piersfinlayson/usb-ppps-hub/DEVELOPMENT.md

# USB PPPS Hub Development

The schematic, PCB and JLCPCB files are generated by the scripts in `scripts/`. It is recommended to change the scripts, not the files in KiCad, because regenerating overwrites KiCad edits. The design is in [spec.md](spec.md).

## Setup

Supported on macOS and Linux.

Install:

- [KiCad 9](https://www.kicad.org/download/)
- Python 3 and Git
- Poppler, for the PNG renders (`brew install poppler` on macOS, `poppler-utils` on Linux)
- CMake and the Arm GNU Toolchain (`arm-none-eabi-gcc`), for the EEPROM programmer
- [picotool](https://github.com/raspberrypi/picotool) 2.1.1 or later, for programming a hub
- [OpenSCAD](https://openscad.org/downloads.html#snapshots) development snapshot, for the case (`brew install --cask openscad@snapshot` on macOS)
- [PrusaSlicer](https://www.prusa3d.com/prusaslicer/), optional, for the case G-code

The scripts use KiCad's default install, and `kicad-cli` from the PATH if it's present. If your KiCad, OpenSCAD or PrusaSlicer is elsewhere, set these environment variables:

| Variable | Path |
| --- | --- |
| `KICAD_CLI` | `kicad-cli` |
| `KICAD_PYTHON` | Python with KiCad's `pcbnew` module |
| `KICAD9_SYMBOL_DIR` | KiCad's stock symbol libraries |
| `KICAD9_FOOTPRINT_DIR` | KiCad's stock footprint libraries |
| `OPENSCAD` | `openscad` |
| `PRUSASLICER` | PrusaSlicer |

`scripts/kicad-python` runs a script using KiCad's Python.

## Generating

```bash
scripts/generate.sh
```

This writes:

- the KiCad project and a schematic PDF to `kicad/`
- the JLCPCB files to `jlc/`
- the EEPROM image to `usb-ppps-hub-eeprom.bin`

It stops if there are uncommitted changes or untracked files. To see uncommitted changes in KiCad, run `scripts/check_pcb.sh build` and open `build/usb-ppps-hub.kicad_pro`.

Change ERC exclusions and other project settings in `kicad-src/usb-ppps-hub.kicad_pro`.

## Changing the Schematic

The schematic is generated by `scripts/usb_hub.py`. After changing the script, check the schematic:

```bash
scripts/check.sh build
```

This generates the schematic in `build/`, runs ERC and compares the netlist with `scripts/expected_nets.py`. It prints any netlist differences and ERC violations, and a `LAYOUT` line for overlapping symbols or text and for wires that cross them. The sheet is rendered to `build/sheet-1.png` at 100 dpi, or at `DPI` if set.

ERC violations excluded on a part reappear if the part moves or its reference changes.

`expected_nets.py` is the netlist written by hand from spec.md, separately from `usb_hub.py`. Update it when you change a connection, so a mistake in `usb_hub.py` appears as a netlist difference.

To see part of the sheet close up:

```bash
scripts/crop.sh build hub 50 5 100 60
```

This writes `build/hub.png` at 220 dpi, from x0 y0 to x1 y1 in units of 2.54 mm from the sheet's top left.

## Changing the PCB

The board is generated by `scripts/usb_hub_pcb.py`. Board size, connector pitch, and part and silkscreen positions are parameters at the top of the script. Tracks are built from pad positions, so a passive's footprint size can change without routing changes. The stackup is JLC04161H-7628 and the design rules are JLC's 4-layer limits.

Check the board:

```bash
scripts/check_pcb.sh build
```

This generates the schematic and board in `build/`, runs DRC with schematic parity and prints the violations, unconnected items and parity problems. It renders at 300 dpi or at `DPI` if set:

- the top layers to `build/top.png`
- the bottom copper to `build/bottom.png`
- the In2.Cu power plane to `build/power.png`

Generating the board also prints:

- `PAIR` lines with the length of each USB pair's tracks and the difference within the pair
- `STITCH` with the number of GND stitching vias placed
- `ANGLE` for a track segment that isn't horizontal, vertical or at 45°
- `ACUTE` for a track bend sharper than 90°
- `SILK` for a part with silkscreen outside the board outline
- `VIAPAD` for a via that overlaps a pad
- `UNPLACED` for any part without a position

Ignore DRC warnings that the USB-C connector footprints don't match the library.

To see part of a render close up:

```bash
scripts/crop_pcb.sh build top 30 10 45 30
```

This writes `build/top-crop.png` at 1200 dpi, or at `DPI` if set, from x0 y0 to x1 y1 in mm from the board's top left. The second argument is `top`, `bottom` or `power`.

When the board or case changes, update the renders in the README after running `generate.sh`:

```bash
scripts/render.sh
```

## Case

The case design is `case/usb-ppps-hub-case.scad`. Its specification is in [spec.md](spec.md#case).

```bash
scripts/case.sh build/usb-ppps-hub.kicad_pcb build/case
```

This:

- reads the board's size and its hole, connector and LED positions from the PCB into `build/case/board.scad`
- writes the base and lid STLs
- fails if the board, base and lid overlap
- writes G-code files for the for an Original Prusa MK3S with Prusament PLA, 0.20mm SPEED and 15% infill, if PrusaSlicer is installed.

`check_all.sh` runs it.

To see the case, open `build/case/usb-ppps-hub-case.scad` in OpenSCAD and set `part`. Edit `case/usb-ppps-hub-case.scad`, because `case.sh` overwrites the copy.

## Version, Commit and Source Location

The version in `VERSION` is the board version. It is printed in the schematic's title block and on the silkscreen, and written to the EEPROM as bcdDevice. Change it only when the board design is modified.

`generate.sh` sets the commit on the silkscreen to the short hash of HEAD.

https://piers.rocks on the left edge is `SOURCE_LOCATION` in `scripts/usb_hub_pcb.py`. The [LICENSE](LICENSE) and [NOTICE](NOTICE) require it remain on the PCB.

## EEPROM Image

The image is built from the EEPROM contents table in [spec.md](spec.md#hub-configuration):
- A value in double quotes is interpreted as a string.
- The string must be the correct length for the range.
- `VERSION` is the version in the `VERSION` file, used for bcdDevice.

## EEPROM Programmer

The EEPROM is programmed using a Raspberry Pi Pico or Pico 2 using:
- Pico firmware in `programmer/main.c`
- the `programmer/program.py` script to control it from a PC/Mac/Linux host

To build the firmware:

```bash
scripts/build_programmer.sh
```

This builds in `build/` and copies the firmware to:

- `programmer/rp2040.uf2` for a Pico
- `programmer/rp2350.uf2` for a Pico 2

`--clean` deletes the build folders first.

The Pico SDK at `PICO_SDK_PATH` is used. If that isn't set, pico-sdk 2.2.0 is cloned into `build/pico-sdk`.

If picotool 2.1.1 or later isn't installed, the SDK builds one in `build/picotool`. This requires a C++ compiler. That picotool doesn't have USB support so it cannot be used to program a hub.

Wire a Pico or Pico 2 to the hub as described in the [README](README.md#programming-the-eeprom). To program the hub with the EEPROM image from spec.md:

```bash
scripts/program_hub.sh
```

This:

- writes the EEPROM image to `build/`
- builds the firmware
- runs `program.py`

Options, passed to `program.py`:

- `--serial` sets the serial number. Otherwise it is a random 64-bit value from the OS's random number generator.
- `--board-version` sets bcdDevice. Otherwise it is the version from the `VERSION` file.

## JLCPCB Files

`generate.sh` runs `scripts/jlc.py`, which writes the zipped Gerbers and drill files, the BOM and the CPL to `jlc/`.

DNP parts and the mounting holes aren't in the BOM or CPL. `jlc.py` prints `NOLCSC` for any BOM row without an LCSC part number.

If a part is rotated or shifted in JLC's preview, add a correction for its LCSC part number to `CORRECTIONS` in `scripts/jlc.py`.

## Validation

```bash
scripts/check_all.sh build
```

This runs the schematic, board and case checks and builds the EEPROM image. CI runs it with KiCad 9.0.7 and the OpenSCAD 2026.10.11 snapshot and then `scripts/build_programmer.sh --clean`.

OpenSCAD deletes its snapshots after about a year. When CI fails to download the snapshot, change it in both workflows to a newer one.

## Releasing

A release is named after the board version in `VERSION`. The first release for a board version is named the version, for example v0.1.0. Later releases for the same board version add a number, for example v0.1.0-2.

1. If the board design has been modified, set the new version in `VERSION`.
2. Date the release's section in [CHANGELOG.md](CHANGELOG.md), for example `## v0.1.0-2 - 2026-11-07`.
3. Commit.
4. Tag the commit with the release name and push the tag.

The Release workflow creates a GitHub release with the changelog section as its notes. The release contains:

- `usb-ppps-hub-gerbers.zip`, with the tag's commit on the silkscreen
- `usb-ppps-hub-bom.csv` and `usb-ppps-hub-cpl.csv`
- `usb-ppps-hub-eeprom.bin`
- `usb-ppps-hub-schematic.pdf`
- `usb-ppps-hub-kicad.zip`, the KiCad project with LICENSE and NOTICE
- `usb-ppps-hub-case.zip`, the case STLs with LICENSE and NOTICE
- `usb-ppps-hub-programmer.zip`, the EEPROM programmer with `program.py`

`scripts/release.sh v0.1.0` writes the same files to `build/release/`.

## Parts

Each passive's footprint, LCSC part number and MPN are set by value in `PASSIVES` in `scripts/usb_hub.py`. A second source's LCSC part number goes in `ALTS` and appears in the schematic's `LCSC alt` field.

The USB-C connector's footprint is in `kicad-src/usb-ppps-hub.pretty` and the TLV803S symbol in `kicad-src/usb-ppps-hub.kicad_sym`. All other footprints and symbols come from KiCad's stock libraries. If the schematic needs a new stock symbol library, add it to `kicad-src/sym-lib-table` or ERC fails in CI.

## Shipping

The UK HS code for a USB hub is 8471 80 00 00.

## Files

| File | Contents |
| --- | --- |
| `spec.md` | Design spec |
| `VERSION` | Version |
| `scripts/usb_hub.py` | Schematic generator |
| `scripts/kisch.py` | KiCad 9 schematic writer and layout checker |
| `scripts/expected_nets.py` | Netlist written from the spec, independent of `usb_hub.py` |
| `scripts/compare.py` | Netlist comparison and ERC summary |
| `scripts/check.sh` | Schematic generate and check script |
| `scripts/crop.sh` | Schematic region render script |
| `scripts/usb_hub_pcb.py` | PCB generator |
| `scripts/kipcb.py` | KiCad 9 PCB writer |
| `scripts/check_pcb.sh` | PCB generate and check script |
| `scripts/drc_summary.py` | DRC report summary |
| `scripts/crop_pcb.sh` | PCB region render script |
| `scripts/jlc.py` | JLCPCB Gerber, BOM and CPL writer |
| `scripts/eeprom.py` | EEPROM image writer |
| `scripts/render.sh` | Board and case render script |
| `scripts/case.sh` | Case build and check script |
| `scripts/case_board.py` | Board position writer for the case |
| `scripts/case_fit.py` | Case fit check |
| `scripts/kicad_paths.py` | KiCad locations for the Python scripts |
| `scripts/kicad.sh` | KiCad locations for the shell scripts |
| `scripts/kicad-python` | Script runner using KiCad's Python |
| `scripts/check_all.sh` | Combined check script |
| `scripts/generate.sh` | Combined generate script |
| `scripts/release.sh` | Release file writer |
| `scripts/build_programmer.sh` | EEPROM programmer build script |
| `scripts/program_hub.sh` | Hub programming script using spec.md |
| `programmer/main.c` | EEPROM programmer firmware |
| `programmer/CMakeLists.txt` | EEPROM programmer build configuration |
| `programmer/program.py` | Hub programming script using an EEPROM image |
| `case/usb-ppps-hub-case.scad` | Case design |
| `case/Montserrat-ExtraBold.ttf` | Lid text font |
| `case/Montserrat-OFL.txt` | Lid text font licence |
| `scripts/changelog.py` | Changelog section printer |
| `.github/workflows/` | GitHub Actions check and release workflows |
| `kicad/` | Generated KiCad project and schematic PDF |
| `jlc/` | Generated JLCPCB Gerbers, BOM and CPL |
| `usb-ppps-hub-eeprom.bin` | Generated EEPROM image |
| `images/usb-ppps-hub.png` | Generated board render |
| `images/usb-ppps-hub-case.png` | Generated case render |
| `kicad-src/usb-ppps-hub.kicad_pro` | KiCad project with net classes, ERC exclusions, board design settings and the `COMMIT` default |
| `kicad-src/usb-ppps-hub.kicad_sym` | Project symbol library |
| `kicad-src/sym-lib-table` | Symbol library table |
| `kicad-src/usb-ppps-hub.pretty/` | Project footprint library |
| `kicad-src/fp-lib-table` | Footprint library table |
